hektopuss/ThinkPad_RP2040_Keyboard/Pictures/14 Final Build.jpg

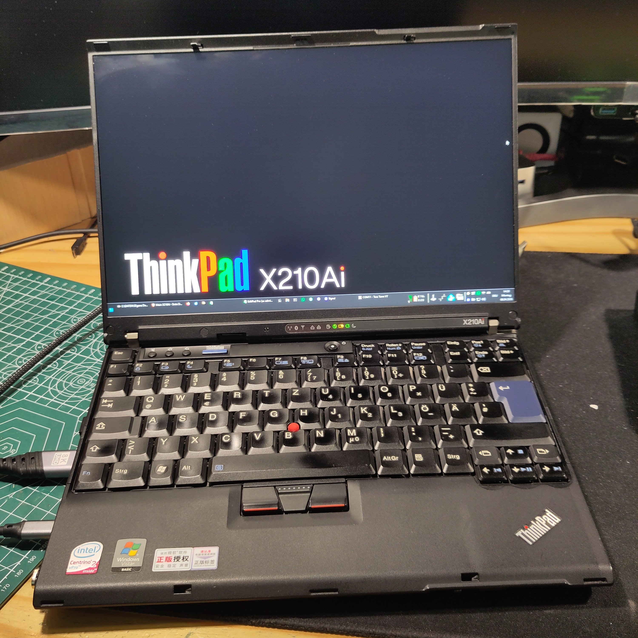
Pictures/14 Final Build.jpg
