hektopuss/ThinkPad_RP2040_Keyboard/Pictures/13 Keyboard Mod #1 Breakoutboard.jpg

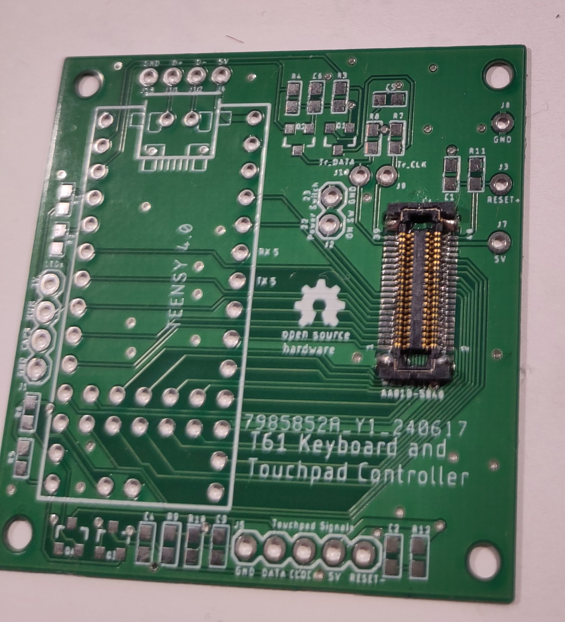
Pictures/13 Keyboard Mod #1 Breakoutboard.jpg
