hektopuss/ThinkPad_RP2040_Keyboard/Keylist.pdf

Regular KeyMap
Teensy I/O

8

7 | 19

4

6

5 | 22 | 23 | KeyTypes
Keyboard

3

5

7 | 13
9 | 11 | 15 | 17
RP2040 GP | 6

5

7

2

4

3

8

9
Ctrl-Left | Ctrl-Right
Shift-Left | Shift-Right

Esc

^ | Tab

1

q

a | Ger:y / Intl:z
TILDE | KEY_Z
Ger: <> | Intl:\| | F1 | Caps-Locks

2

w

s

x
NON_US_BS
F4 | F2 | F3

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
F5 | F9 | Back-Space | F10
\ | Enter | Space
BACKSLASH
h
6 | Ger:z Intl:y

7

u

j

m

n
KEY_Y
F6
´ | }]
8 | i | k

,
EQUAL | RIGHT_BRACE | COMMA | Ignore the german swaps in
F8 | F7

9

o | l | . | green, every ISO-keyboard
PERIOD | reports the same keycodes
Ger:ä Intl:" | Ger:ß Intl:- | Ger:ü Intl:[{

0

p | Ger:ö Intl:; | Ger:#' Intl:#~\ | Ger:- Intl:/ | regardless of the keycaps.
QUOTE | MINUS | LEFT_BRACE | SEMICOLON | BACKSLASH | SLASH | That is why you need to
Delete | Vol-Down | F11 | Vol-Up | Mute | Cursor Down | select the current keymap
in your OS
Insert | F12 | Cursor Right
Page-Up | Page-Down | GUI/Win | Menu | Document-Left | Document-Right
AC_BACK | AC_FORWARD
Cursor Up | Home | End | Pause | Cursor Left
Alt-Left | Print-Screen | Scroll-Lock | Alt-Right

Fn Key-Combo

27 12

ANSI-Key
Missing in ISO

16

8

Added in ISO
Missing in ANSI

24 20

Multimedia

29 | 16 | ThinkVantage

switched Ger/Eng

9

4

NumPad

26 | 22
28 | 26

13

26

25 | 10 | 17
33 | 6
15 | 2
32 | 30
31 | 18
17 | 14
14 | 24

11

22

10 32

Regular Key

30 28

Modifier

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
Num-Lock
Teensy I/O | 8 | 7 | 19 | 4 | 6 | 5 | 22 | 23 | KeyTypes
Keyboard | 3 | 5 | 7 | 13 | 9 | 11 | 15 | 17
RP2040 GP | 6 | 5 | 7 | 2 | 4 | 3 | 8 | 9
| | Ctrl-Left | | | | | Ctrl-Right
| | | Shift-Left | | | | Shift-Right
| Esc | ^ | Tab | 1 | q | a | Ger:y Intl:z
| | TILDE | | | | | KEY_Z
| Ger: <>| Intl:\| | F1 | Caps-Lock | 2 | w | s | x
| NON_US_BS
| F4 | F2 | F3 | 3 | e | d | c
| g | 5 | t | 4 | r | f | v | b
| F5 | F9 | Back-Space | F10 | | \ | Enter | Space
| | | | | | BACKSLASH
| h | 6 | Ger:z Intl:y | 7 | 4 | 1 | 0 | n
| | | KEY_Y | KEYPAD_7 | KEYPAD_4 | KEYPAD_1 | KEYPAD_0
| F6 | ´ | }] | 8 | 5 | 2 | ,
| | EQUAL | RIGHT_BRACE | KEYPAD_8 | KEYPAD_5 | KEYPAD_2 | COMMA | | Ignore the german swaps in
| | F8 | F7 | 9 | 6 | 3 | . | | green, every ISO-keyboard
| | | | KEYPAD_9 | KEYPAD_6 | KEYPAD_3 | KEYPAD_PERIOD | | reports the same keycodes
| Ger:ä Intl:" | Ger:ß Intl:- | Ger:ü Intl:[{ | / | * | - | Ger:#' Intl:#~\ | + | regardless of the keycaps.
| QUOTE | MINUS | LEFT_BRACE | KEYPAD_SLASH | KEYPAD_ASTERIX | KEYPAD_MINUS | BACKSLASH | KEYPAD_PLUS | That is why you need to
| | Delete | Vol-Down | F11 | Vol-Up | Mute | | Cursor Down | select the current keymap
in your OS
| Insert | F12 | | | | Cursor Right
| Page-Up | Page-Down | GUI/Win | Menu | Document-Left AC_BACK | Document-Right AC_FORWARD
Cursor Up | Home | End | | | Pause | Cursor Left
Alt-Left | Print-Screen | Scroll-Lock | Alt-Right 10 | 32

Regular Key

30 28

Modifier

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
27 12

ANSI-Key
Missing in ISO

16 8

Added in ISO
Missing in ANSI

24 20

Multimedia

29 | 16 | ThinkVantage

switched Ger/Eng

14

19

21

16

32 | 30
31 | 18
17 | 14
9 | 4

NumPad

26 | 22
28 | 26

10

Fn Key-Combo

14 | 24
25 | 10
33 | 6
15 | 2

12

22

11

Fn-Overlay
Teensy I/O | 7 | 8 | 7 | 19 | 4 | 6 | 5 | 22 | 23 | KeyTypes
Keyboard Pin 5 | 3 | 5 | 7 | 13 | 9 | 11 | 15 | 17
| RP2040 GP | 6 | 5 | 7 | 2 | 4 | 3 | 8 | 9

F1

F4 / Sleep | F2 / Lock | F3 / Screen Saver
| (Win+L)
F5 / Wifi-Toggle | F9 / Eject | F10 | Space / Zoom
MEDIA_EJECT
| | 7 | 4 | 1 | 0
| | KEYPAD_7 | KEYPAD_4 | KEYPAD_1 | KEYPAD_0
F6 | 8 | 5 | 2
| | KEYPAD_8 | KEYPAD_5 | KEYPAD_2 | | Ignore the german swaps in
F8 | F7 / Project | 9 | 6 | 3 | . | green, every ISO-keyboard
Track Point/Pad | (Win+P) | KEYPAD_9 | KEYPAD_6 | KEYPAD_3 | KEYPAD_PERIOD | reports the same keycodes
/ | * | - | + | regardless of the keycaps.
KEYPAD_SLASH | KEYPAD_ASTERIX | KEYPAD_MINUS | KEYPAD_PLUS | That is why you need to
Delete | F11 | Play/Pause | select the current keymap
MEDIA_PLAY_PAUSE | in your OS
| Insert ThinkLight | F12 / Hibernate | | Next Track MEDIA_NEXT_TRACK
| | | |< >| MEDIA_REWIND MEDIA_FAST_FORWARD
Stop Screen Bright-MEDIA_STOP ness Up | | Screen Bright-ness Down | Pause | Prev Track MEDIA_PREV_TRACK
SysReq | Num-Lock 10 | 32

Regular Key

30 28

Modifier

24

20

18

23

15

17

26

27 12

ANSI-Key
Missing in ISO

16 8

Added in ISO
Missing in ANSI

24 20

Multimedia

29 | 16 | ThinkVantage

switched Ger/Eng

14

19

21

16

28 | 26
32 | 30
31 | 18
9 | 4

NumPad

26 22

Fn Key-Combo

13

10

15 | 2
14 | 24
17 | 14
25 | 10
33 | 6

12

22

11

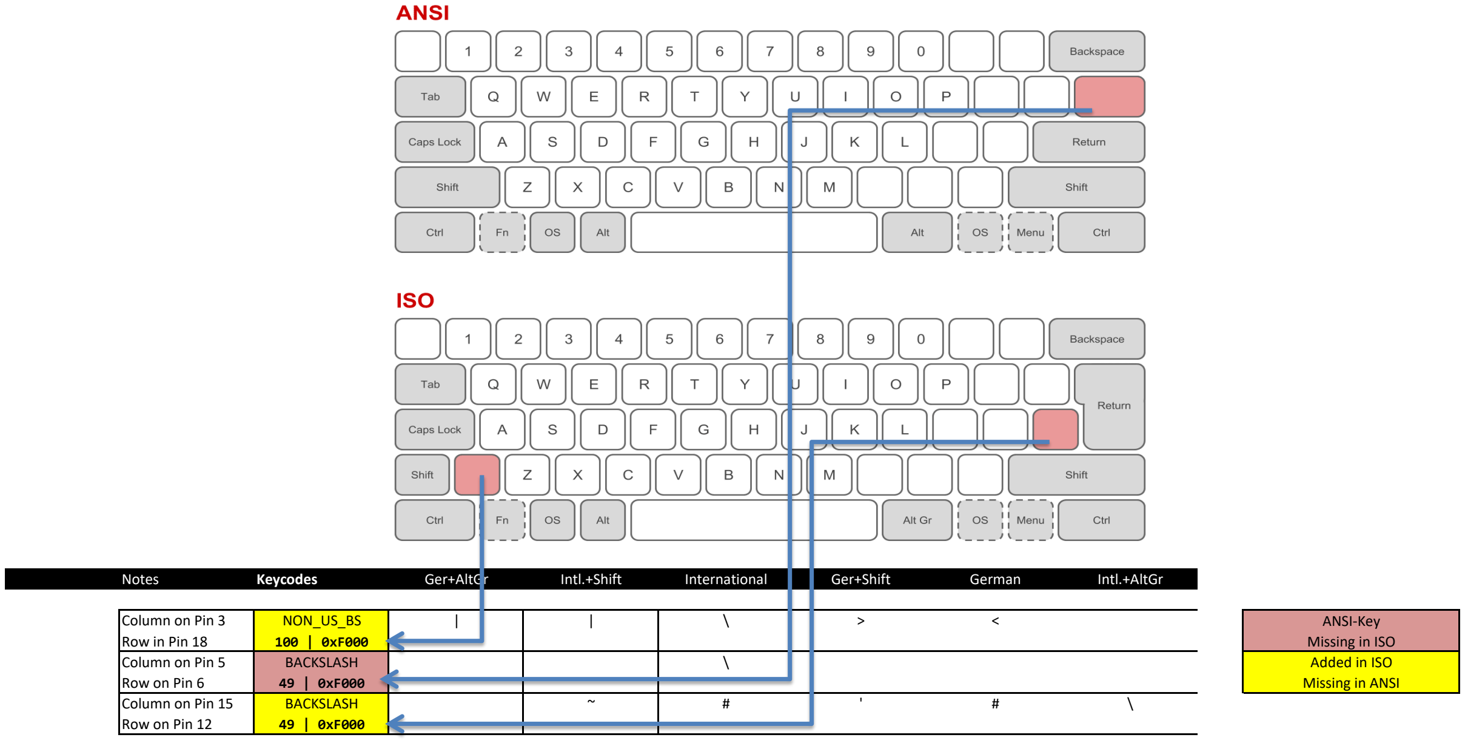
[picture p3: page 4]

Notes | Keycodes | Ger+AltGr | Intl.+Shift | International | Ger+Shift | German | Intl.+AltGr
Column on Pin 3 | NON_US_BS | | | | | \ | > | <
Row in Pin 18 | 100 | 0xF000
Column on Pin 5 | BACKSLASH | | | \
Row on Pin 6 | 49 | 0xF000
Column on Pin 15 | BACKSLASH | | ~ | # | ' | # | \
Row on Pin 12 | 49 | 0xF000

ANSI-Key
Missing in ISO
Added in ISO
Missing in ANSI

Identifier | KeyCode | Keys pressed
AC_FORWARD | 0x225 | 0xE400 | Document right | works as Forward/Back in most applications (e.g. browser)
AC_BACK | 0x224 | 0xE400 | Document left
AC_ZOOM | 0x22F | 0xE400 | Fn+Space | does not do anythink in Windows
BRIGHTNESS_INC | 0x6F | 0xE400 | Fn+Home | working on Windows
BRIGHTNESS_DEC | 0x70 | 0xE400 | Fn+End | but your screen needs to support changing the brightness over HDMI/DP
AL_CALCULATOR | 0x192 | 0xE400 | ThinkVantage | Calculator on ThinkVantage-Button, but could be anything else
MEDIA_MUTE | 0xE2 | 0xE400 | Mute | all working
MEDIA_VOLUME_DEC | 0xEA | 0xE400 | Volume Down
MEDIA_VOLUME_INC | 0xE9 | 0xE400 | Volume Up
MEDIA_PREV_TRACK | 0xB6 | 0xE400 | Fn+Left | all working
MEDIA_NEXT_TRACK | 0xB5 | 0xE400 | Fn+Right
MEDIA_PLAY_PAUSE | 0xCD | 0xE400 | Fn+Down
MEDIA_STOP | 0xB7 | 0xE400 | Fn+Up
MEDIA_FAST_FORWARD | 0xB3 | 0xE400 | Fn+DocRight | working on windows
MEDIA_REWIND | 0xB4 | 0xE400 | Fn+DocLEft | using these two keys additionally to the blue imprints for media control
AL_TERMINAL_LOCK | 0x19E | 0xE400 | Fn+F2 | does not work on Windows, send Win+L instead
AL_SCREEN_SAVER | 0x1B1 | 0xE400 | Fn+F3 | does not do anythink in Windows
SYSTEM_SLEEP | 0x82 | 0xE200 | Fn+F4 | works on Windows
AL_WIFI_STATUS | 0x1AD | 0xE400 | Fn+F5 | does not do anythink in Windows
SYSTEM_PROJECT | 0xB5 | 0xE200 | Fn+F7 | does not work on Windows, send Win+P instead
| | Fn+F8 | used internally to switch TrackPoint on/off
MEDIA_EJECT | 0xB8 | 0xE400 | Fn+F9 | does not seem to work
SYSTEM_HIBERNATE | 0x81 | 0xE200 | Fn+F12 | works on Windows

// Keycodes-Ranges:
// | 32 - 127 | ASCII direct (U+0020 to U+007F) <-- uses layout
// | 128 - 0xC1FF Unicode direct (U+0080 to U+C1FF) <-- uses layout
// 0xC200 - 0xDFFF Unicode UTF8 packed (U+0080 to U+07FF) <-- uses layout // 0xE000 - 0xE0FF Modifier key (bitmap, 8 keys, shift/ctrl/alt/gui)
// 0xE200 - 0xE2FF System key (HID usage code, within usage page 1)
// 0xE400 - 0xE7FF Media/Consumer key (HID usage code, within usage page 12) // 0xF000 - 0xFFFF Normal key (HID usage code, within usage page 7)
