hektopuss/ThinkPad_RP2040_Keyboard/Pictures/13 Keyboard Mod #2 Raspberry Pico.jpg

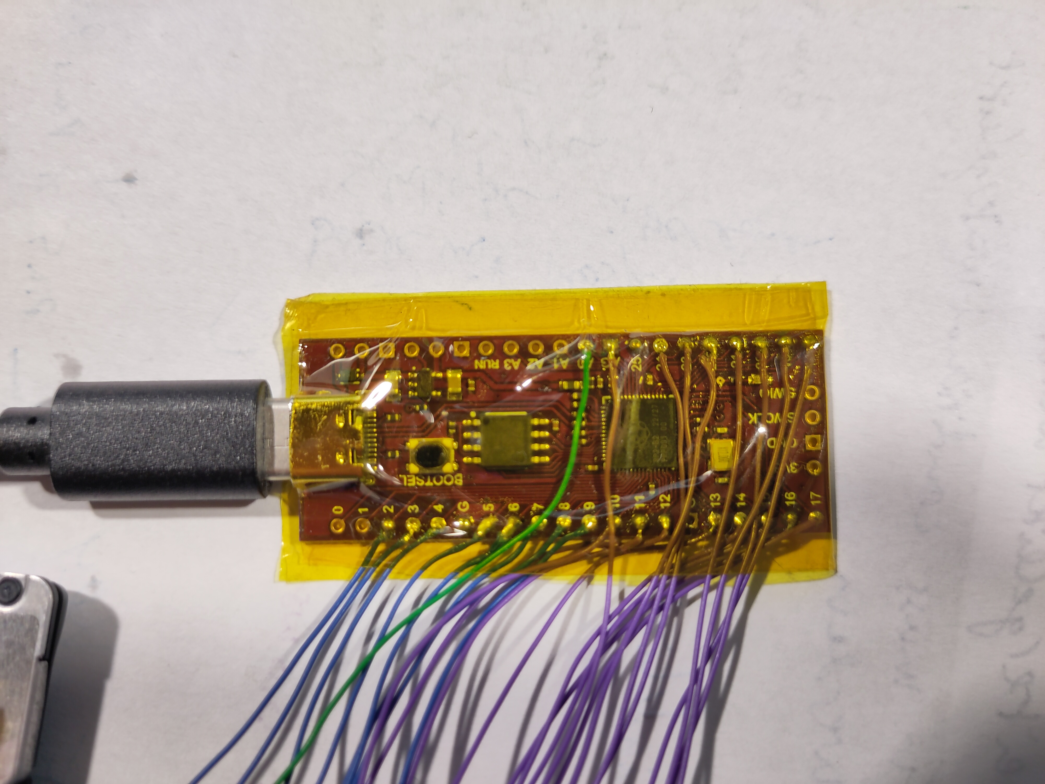
Pictures/13 Keyboard Mod #2 Raspberry Pico.jpg
