hektopuss/ThinkPad_RP2040_Keyboard/Pictures/13 Keyboard Mod #4 Power Button Connection.jpg

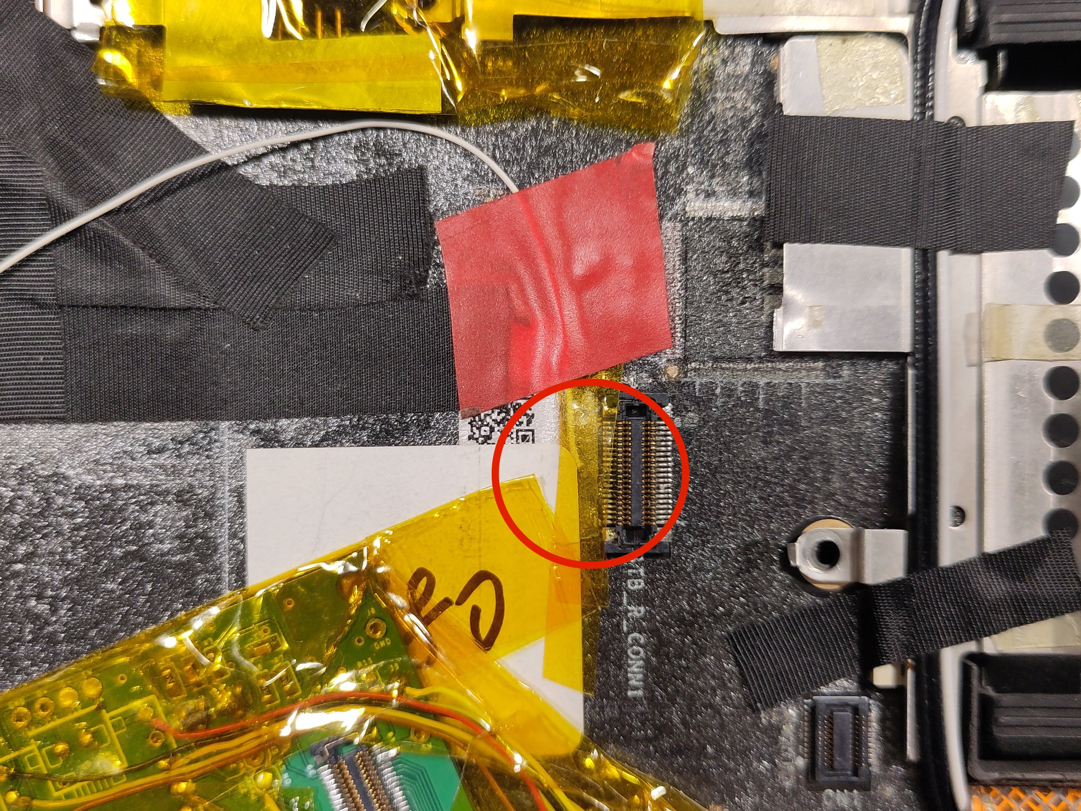
Pictures/13 Keyboard Mod #4 Power Button Connection.jpg
