hektopuss/ThinkPad_RP2040_Keyboard/(notices)

Notices in the files:
ThinkPad_RP2040_Keyboard/ThinkPad_RP2040_Keyboard.ino:
modify it under the terms of the GNU General Public License a
published by the Free Software Foundation, version 3.
